ODZ-UJF-AV-CR/FIK-9/doc/RPD/src/img/balon_vibrace.odp

take off

burst

landing

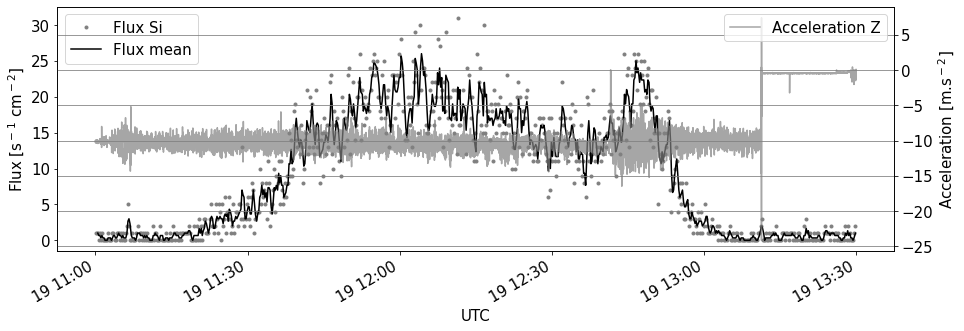
[picture p13: figure]
