ODZ-UJF-AV-CR/FIK-9/doc/img/433_SiK_QFH.png

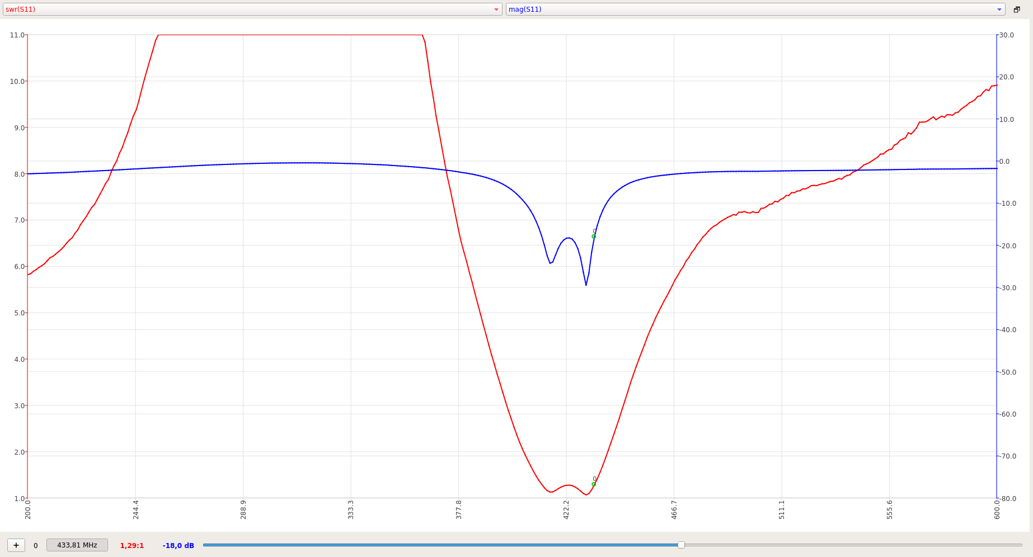
doc/img/433_SiK_QFH.png
