ODZ-UJF-AV-CR/FIK-9/doc/img/868_LoRa_QFH.png

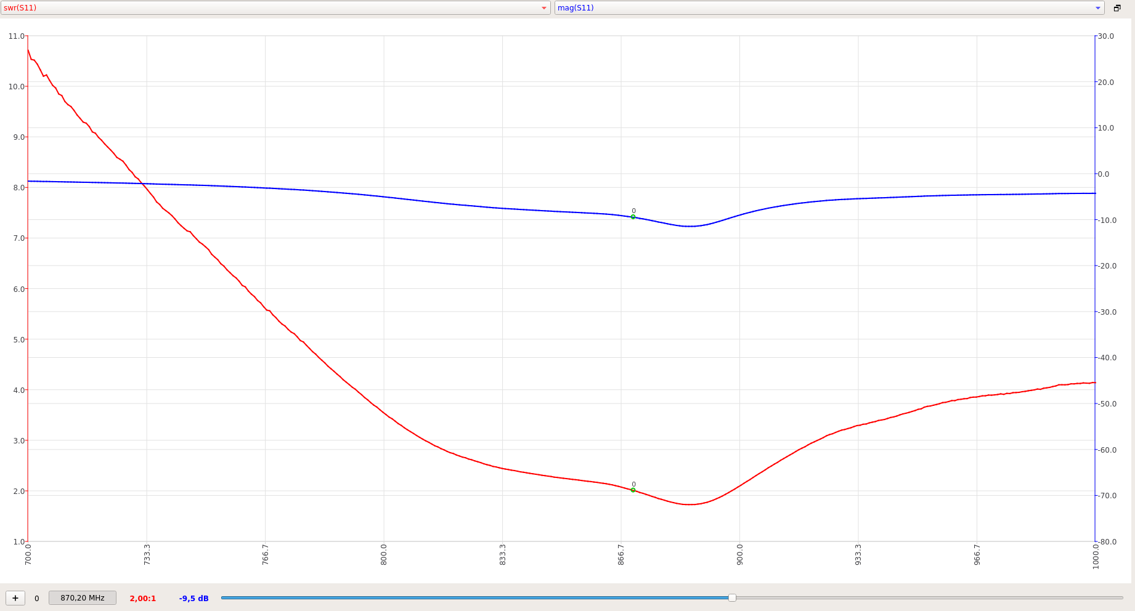
doc/img/868_LoRa_QFH.png
