ODZ-UJF-AV-CR/FIK-9/doc/img/868_LoRa_whip.png

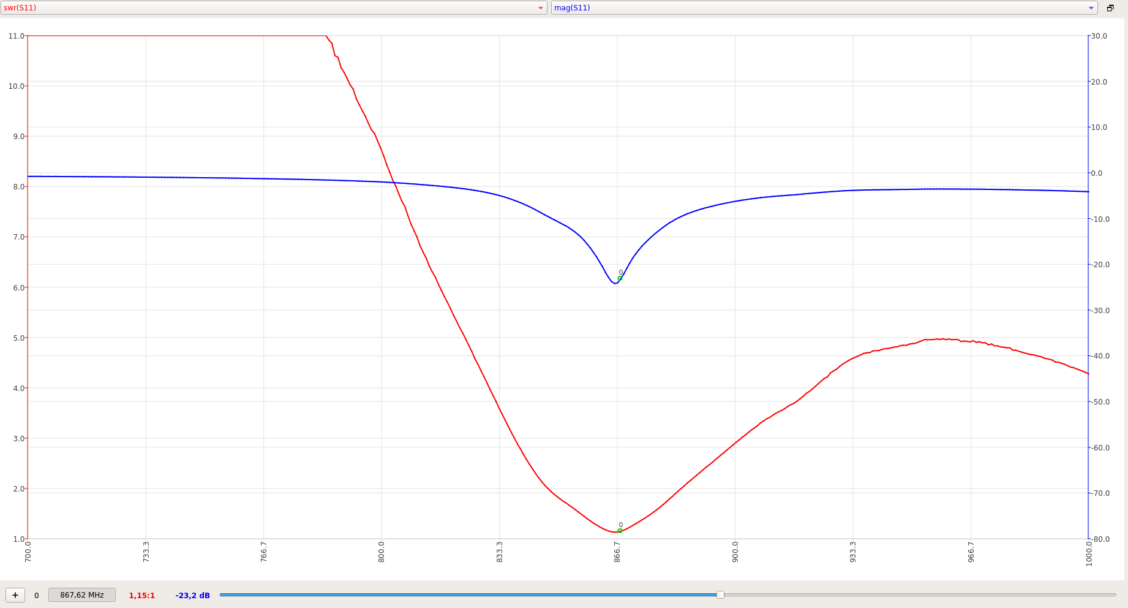
doc/img/868_LoRa_whip.png
