ODZ-UJF-AV-CR/FIK-9/doc/img/FIK-6_balloon_burst.png

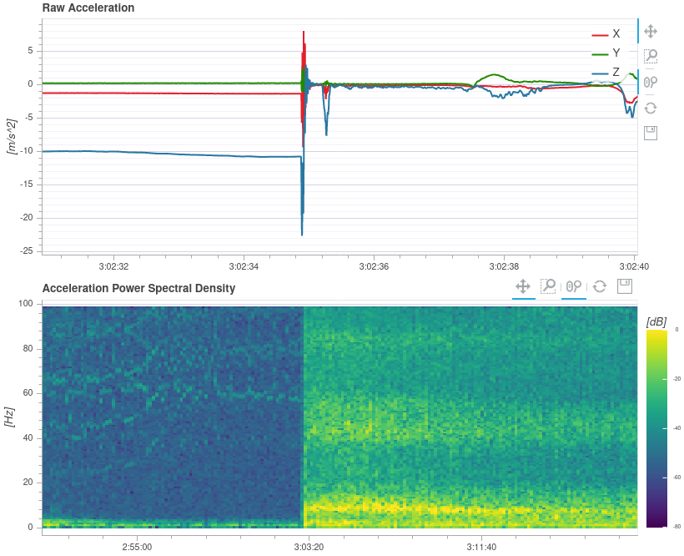
doc/img/FIK-6_balloon_burst.png
