ODZ-UJF-AV-CR/FIK-9/doc/img/FIK-6_flight_path.png

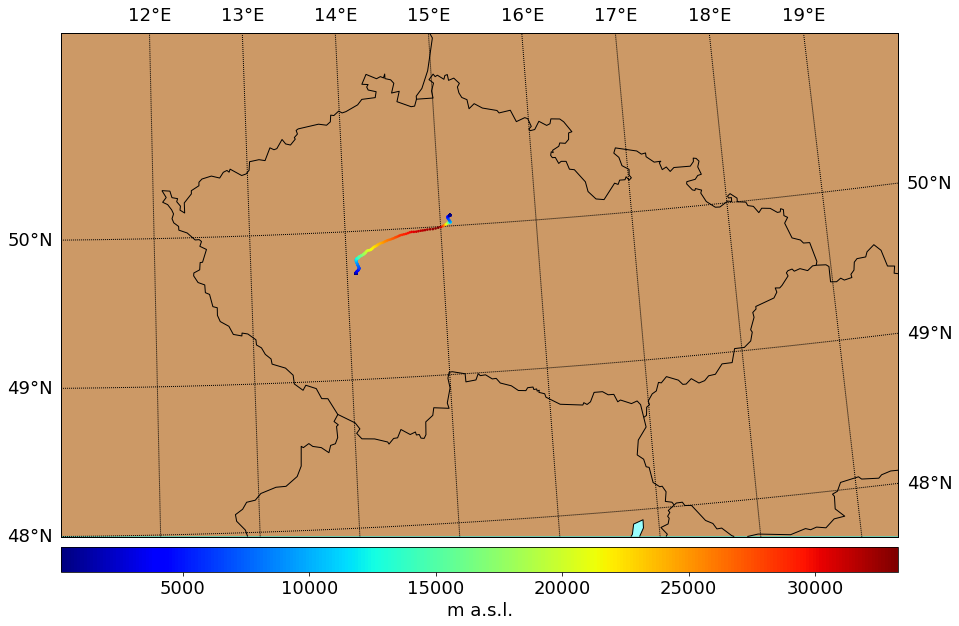
doc/img/FIK-6_flight_path.png
