ODZ-UJF-AV-CR/FIK-9/doc/RPD/src/img/FIK-6_acceleration.png

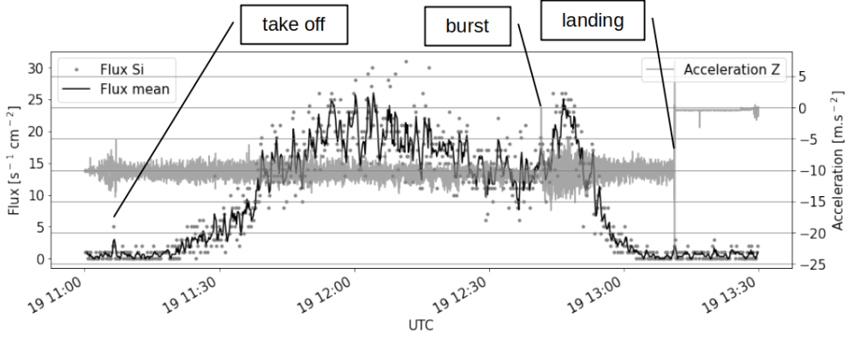
doc/RPD/src/img/FIK-6_acceleration.png
