ODZ-UJF-AV-CR/FIK-9/doc/RPD/src/img/FIK-6_angular_speed.png

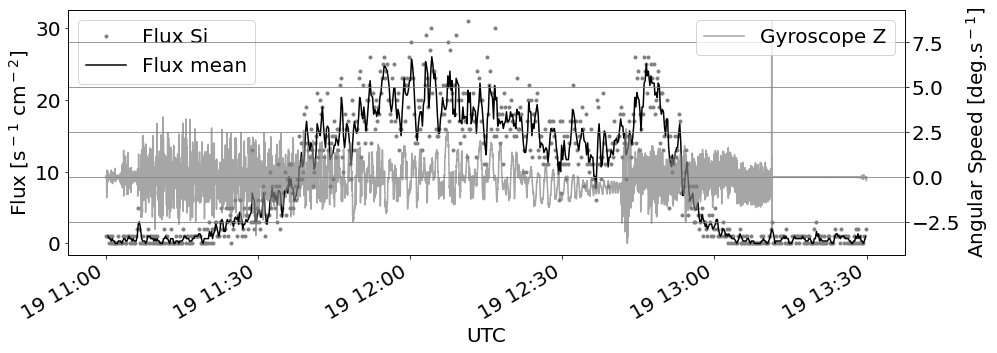
doc/RPD/src/img/FIK-6_angular_speed.png
