ODZ-UJF-AV-CR/FIK-9/(threads)

Thread 1 (2023-09-27):

Separation device design

kaklik, 2023-09-27:
S ohledem na další vývoj balonových experimentů směrem k [řízenému sestupu do definované oblasti](https://github.com/ODZ-UJF-AV-CR/FIK-X). Je důležité vyvinout nebo jinak získat separační zařízení, které v maximální výšce letu oddělí gondolu s padákem od balonu.

## Požadavky na takové zařízení

- Vysoká spolehlivost odpojení
  -  zařízení musí přerušit lano vedoucí od balonu k vrchlíku padáku
- Možnost během letu ovlivnit čas/místo odpojení
  -  Vzdálené řízení z pozemní stanice
- Nízká hmotnost ( nižší nebo srovnatelná s hmotností padáku)
- Část která zůstane na balonu by neměla být nebezpečná při dopadu na zem, nebo jinak nebezpečná pro ostatní provoz.

## Aktuálně dostupná řešení

- [HAB cutter](https://loonatec.com/product/hab-cutter/)
- [HAB Bounder](https://loonatec.com/product/balloon-cut-down-system/)

Obě tato řešení, kromě toho, že nesplňují úplně přesně požadavky, které na takové zařízení máme jsou ještě relativně drahá.

# Možná technická realizace

## Způsob ovládání

## Mechanická konstrukce

### Použití serva s háčkem

### Motor, který rozšroubuje šroubový spoj

### Přepálení vlákna rezistorem

### Gilotina, která přesekne lano

Thread 2 (2023-10-11):

Lora Data Pump

slimonslimon, 2023-10-11:
Jednoduchá aplikace přenášející data z TTN sítě (https://eu1.cloud.thethings.network/console/ ) do SonderHub (https://amateur.sondehub.org/) a do Ground Aplikace (jiné issue).

  - Vzhledem k tomu, že starší verze byly napsané v pythonu a ten umí aspoň trochu většina z nás, tak navrhuji python.
   - V případě, že selže zaslání dat na Ground APP, aplikace a pokusí se navázat spojení při dalším heardbeat, či datech

 - [ ] příjem dat z TNN
 - [ ] upload dat na SonderHUB
 - [ ] upload dat na Ground APP
 - [ ] heartbeat na Ground APP (30s ?)

Thread 3 (2023-10-11):

Sik Data Pump

slimonslimon, 2023-10-11:
Aplikace, která příjmá na HTTP API data od aut a uploaduje je na SonderHub a Ground APP

  - Nějaké verze zřejmně existovala asi v pythonu (možná každé auto uploadovalo přímo na sonderhub)
  - Auto může přijmout data z balonu, ale nemusí mít zrovna internet, zasílá tedy data se zpožděním. Jiné auto ale mohlo mezi tím přijmout čerstvejší informace z balonu. Aplikace pak nebude uploadovat na SonderHUB data, která jsou starší než data, která již uploadovala. Data budou opatřena nějakou časovou známkou (asi z autopilota i z auta)
  -  Na Ground APP se zašlou všechna přijatá data, aby je aplikace mohla zalogovat. A zbrazovat, které auto co přijalo

  -  [ ] příjem dat na HTTP API
  -  [ ] deduplikace dat (víc aut přijme stejná data)
  -  [ ] vyřešení příjmu starších dat
  -  [ ] odeslání dat na SonderHUB
  -  [ ] odeslání dat na Ground APP
  -  [ ] heartbeat na Ground APP, aby bylo jasné že aplikace běží

roman-dvorak, 2023-10-11:
Chápu to tak, že každé auto bude posílat data na sondehub? Mne tato aplikace připadá jako velice nabytečná. A že data na sondehub má posílat jen jedna (ta centrální) aplikace. Tohle tu celou strukturu značně komplikuje a vytváří mnoho cest, jakdata mohou téct. Což mi nepřipadá jako optimální.

Trochu toto řešění chápu. Ale ne v našich měřítkách.

Já bych tuto aplikaci vyřadil a #4 a #5 bych nechal uploadovat přímo na centrální web. #5 může svou polohu posílat na sondehub rovnou.
