ODZ-UJF-AV-CR/FIK-9/scripts/set9600.py

#!/usr/bin/env python3

import serial
import time
import random
import sys

r1 = serial.Serial("/dev/ttyUSB0", baudrate=57000, timeout=0)

def query(r, cmd):
	r.write(cmd + b"\r")
	time.sleep(0.1)
	reply = r.read(100)
	print(r.port, cmd, reply)
	return reply

def enter_at_mode(r):
	query(r, b"ATO")
	time.sleep(0.2)
	for _ in range(3):
		print("sending +++ to %s" % r.port)
		r.write(b"+++")
		time.sleep(0.1)
		r.read(16)
		time.sleep(1.0)
		maybe_ok = r.read(16).strip()
		if maybe_ok == b"OK":
			print("AT mode entered")
			return True
	return False

def settings():
	enter_at_mode(r1)
	query(r1, b"")
	query(r1, b"ATI")
	query(r1, b"ATI5")
	query(r1, b"ATS1=9")
	query(r1, b"AT&W")
	query(r1, b"ATZ")
	time.sleep(0.5)
	query(r1, b"ATO")

def	main():
	settings()
	return

if __name__ == "__main__":
	main()
