ODZ-UJF-AV-CR/FIK-9/(commit log)

2020-10-27 Add a submodule with telemetry antenna design.
2020-10-30 Add link to the LION2CELL01 power module documentation.
2020-11-10 new block schematics
2020-11-10 new block schematics picture
2020-12-05 new configuration of sensors for FIK6
2020-12-07 Fix correct serial speed for balloon modem.
    [configure_balloon_modem.py]
2020-12-18 Increase TXpower Resolve #18
    [configure_balloon_modem.py]
2020-12-20 Save the final, flown autopilot firmware
2020-12-20 Save the flown SiK firmware
2021-01-18 Schematics updated according to real flight configuration.
2021-02-18 NaITl calibration
2021-11-10 The first compilable version of Radiation Protection Dosimetry.
    [color.cfg, crop.cfg, graphics.cfg]
2021-11-11 Fix issues. The first working version of latex document.
    [color.cfg, crop.cfg, graphics.cfg]
2021-11-14 Improve schematics.
2021-11-14 Add link to li-ion power module.
2021-11-26 Fix brackets in acknowledgement.
2023-10-03 Update README.md
    Update Readme to track curent state of Fik-9
2023-11-23 Create sondehub.py
    simple sample
2023-12-03 Add documentation for used antennas.
2023-12-03 Add measurement of used antennas.
2023-12-27 Update README.md
    Add links to the used devices
